Ahmed-A-A-Elhag/GSM_TEMP_MONITOR/README.md

# GSM_TEMP_MONITOR

## Objective:

To design a system that monitors the temperature of a room and sends SMS in one of three cases:

- The temperature exceeds a certain point specified by the user (set point_high).
- The temperature decrease to a certain point also specified by the user (set point_low).
- The temperature rise rate exceeds a certain rate also specified by the user (rate threshold).
