Ahmed-A-A-Elhag/GSM_TEMP_MONITOR/(list of files, drawings)

Other design files:
simulation.pdsprj
